jullyoemmanuel/projeto-bomba-infus-o/Diagramas/Esquemático.drawio.docx

Fora da infusão

Botão

Ligar

Mostra mensagem de inicialização

Tela inicial

Confirmação de

duas etapas Fora da infusão Botão

Menu Mostrar Menu Pegar parâmetros de infusão

Iniciar

infusão?

Tela inicial Não Botão

Esc

Pega volume

Sim

Botão Enter

Pega modo de infusão

Qual

Modo A

Iniciar infusão

Liga bomba

Mostra volume e

modo? Pede vazão Botão

F1

tempo restante

Botão F2

Modo B Calcula T(infusão) e velocid. do motor

Alarme de fim de

infusão Tela inicial Botão

Enter

Pede tempo

Calcula vazão e velocid. do motor

Confirmação de

Confirmação de

duas etapas Durante infusão Fora da infusão duas etapas

Botão KVO

Modo

KVO? Retomar infusão Não Botão

Esc

Sim Botão

Enter

Modo KVO

Calcula vazão, tempo

e ajusta bomba

Confirmação de

Botão

Configurar KVO

Mudar

KVO? Tela inicial Não Botão

Esc

Sim Botão

Enter

Mudar vazão KVO

Pega vazão de KVO

e atualiza

Confirmação de

Tela inicial

Durante infusão Fora da infusãoduas etapas

duas etapas

Botão Pausar

Pausar

infusão? Retomar infusão Não Botão

Esc

Sim Botão

Enter

Deseja

Botão

Desligar

Desligar

bomba? Tela inicial Não Botão

Esc

Sim Botão

Enter

Desligar bomba

retomar

Sim Botão

Enter

Retomar infusão

Tela inicial Não Botão

Esc

Desliga motor e apaga display

Confirmação de

duas etapas Durante infusão

Botão Parar

Parar

infusão? Retomar infusão Não Botão

Esc

Sim Botão

Enter

Parar infusão

Desliga motor

Tela inicial
