jullyoemmanuel/projeto-bomba-infus-o/Diagramas/Prática5_EsquemaElétrico.png

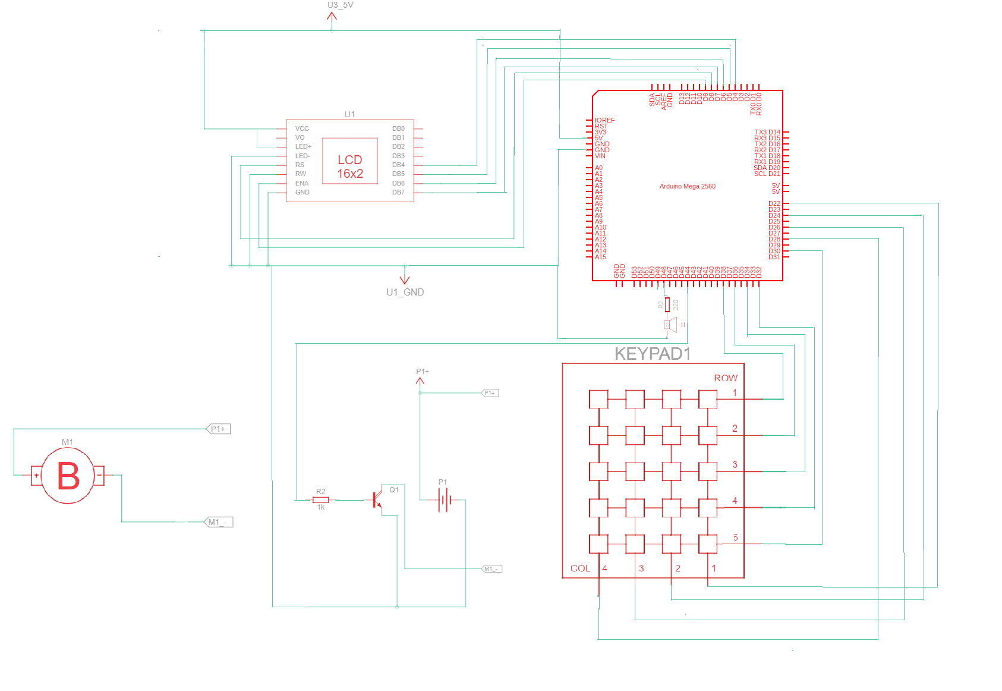
Diagramas/Prática5_EsquemaElétrico.png
