jullyoemmanuel/projeto-bomba-infus-o/Diagramas/Diagrama.drawio.pdf

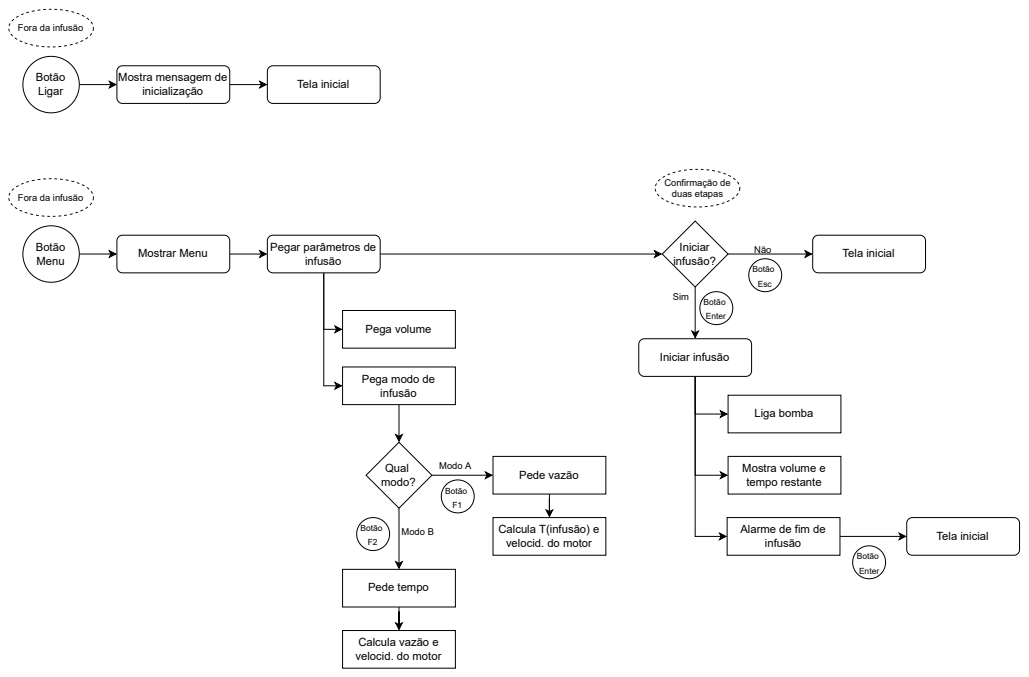
[picture p21: page 1]
Botão; Botão Ligar; Menu; Mostrar Menu; Pegar parâmetros de; infusão; Iniciar infusão?; Tela inicial; Iniciar infusão; Sim; Liga bomba; Mostra volume e tempo restante; Pega volume; Qual; modo?; Pede vazão; Modo A; Pede tempo; Modo B; Calcula T(infusão) e; Enter; Esc; Confirmação de

Fora da infusão

Mostra mensagem de
inicialização

duas etapas Fora da infusão

Tela inicial Não

Pega modo de
infusão

Alarme de fim de

velocid. do motor

Calcula vazão e

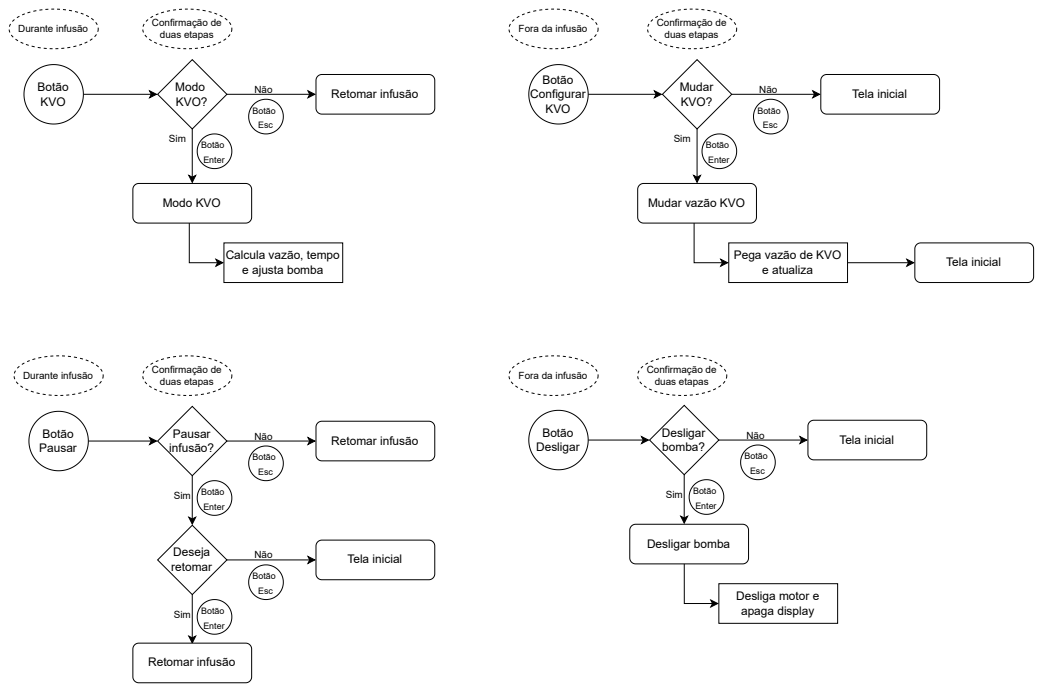
[picture p22: page 2]
Botão Desligar; Botão KVO; Botão Pausar; Modo; KVO?; Retomar infusão Não; Modo KVO; Sim; Botão; Enter; Esc; Pausar; infusão?; Deseja retomar; Desligar; bomba?; Tela inicial Não; Desligar bomba; Desliga motor e apaga display; Retomar infusão; Confirmação de duas etapas; Botão Configurar KVO; Mudar; Confirmação de; duas etapas Durante infusão; Fora da infusão; Tela inicial; Durante infusão

Mudar vazão KVO

Calcula vazão, tempo
e ajusta bomba

Pega vazão de KVO
e atualiza

Tela inicial Não

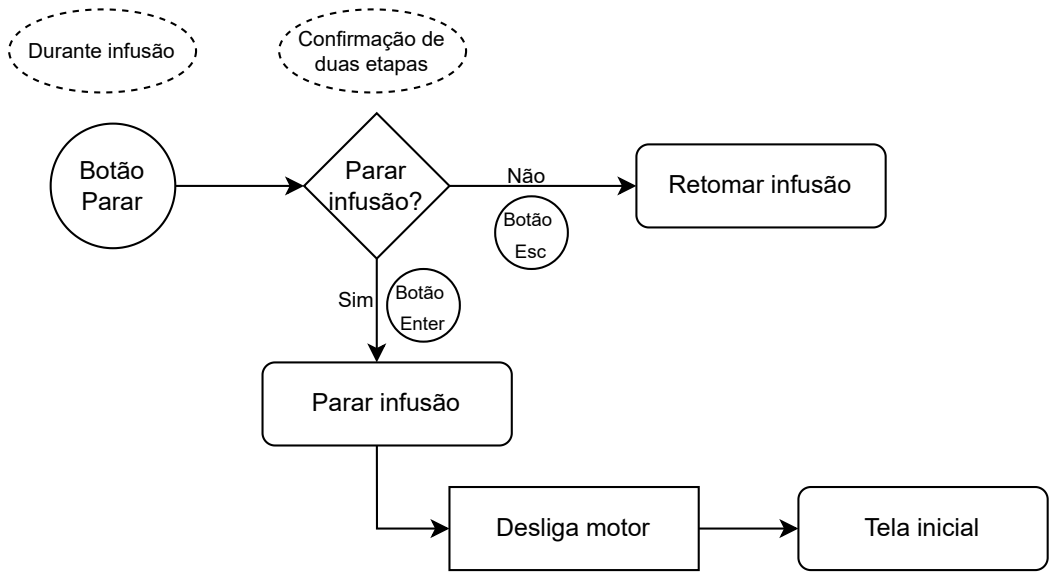
[picture p23: page 3]
Botão Parar; Parar; infusão?; Retomar infusão Não; Sim; Botão; Enter; Esc; Parar infusão; Desliga motor; Confirmação de; Tela inicial

duas etapas Durante infusão
